hakanpolat/Fiero/README.md

# Fiero Converters
Fiero Converters Offical Github Page

# Turning Coffee Into Electricity

Report link on sharelatex: https://tr.sharelatex.com/read/vdbjvnhbgkjp
