hakanpolat/Fiero/Software2report.pdf

Middle East Technical University

EE464 Power Electronics

# ”Turning Coffee into Electricity”

Project 2 Report

## April 21, 2018

## Asena Melisa SARICI -2031284

## Hakan POLAT -

## U˘gur Can YILMAZ - 2031680

To be submitted to

## Ozan KEYSAN

## Contents

1 Introduction | 2
2 Isolated Converter Simulation | 2
3 Controller Design | 9
4 Load and input Change Adaptation | 12
5 Discussion | 14
6 References | 14

## 1 Introduction

As Fiero Converters, we manufacture 230 V AC to 9 V DC, 10 W Flyback Converters.

This documents shows the detailed pre-manufacturing process of designing, simulating of

the converter and the controller of the product. The design to be used in the simulations

is provided in figure 1.

## 2 Isolated Converter Simulation

The design is made using []. There is snubber in order to reduce the current and voltage

stress the MOSFET endures during operation. The resultant effect of the snubber is

clearly observed in the simulations as well. The simulations were done synchronously

with the implementation and hence the design parameters for the switch, diode and the

transformer are taken from the implemented products.


Figure 1: Flyback Design

### 2.1 Part I. Steady State Operation of the Converter

The figures 2, 3, 4, 5 show the simulation waveforms and the resultant voltage, current and

power outputs for the calculated values of maximum duty cycle, turns ratio, reasonable

capacitor values and resistance for the ideal case.


Figure 2: Load Steady State Voltage

Figure 3: Load Steady State Current

Figure 4: Rectifier Output Voltage at Steady State


Figure 5: All voltage current display values

Moreover, we have also checked that the switch voltage and current remains in the

tolarable range. As expected, the voltage across the switch will be twice the input voltage

when it turns off. This can be seen in figure6.

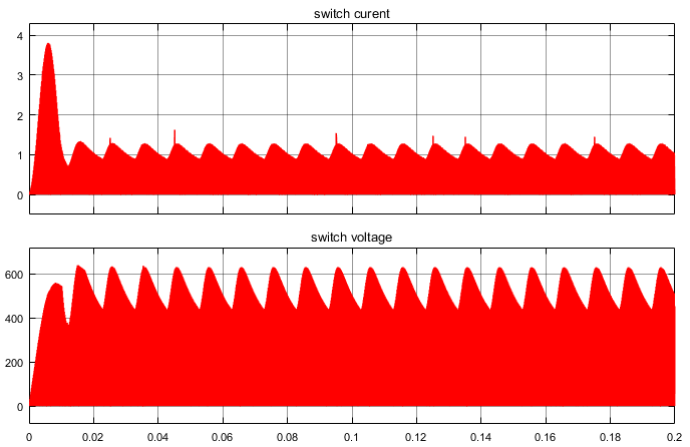
[picture p28: figure]

Figure 6: Current and voltage of the MOSFET during operation

### 2.2 Transformer Design

Throughout the design procedure we followed the steps of Wurth Transformers.

We started our design by defining our specs for the flyback converter which is present in

??.

Vin | 220Vac
Vout | 9 V
Pout | 9 W
Table 1: Specs of our flyback converter design

The flyback converter transfers the power stored in the core in off state and the ∆Ilm

stays the same since its formula depends on constant values.

∆Ilm =

VinDTs
Lm

Therefore it is important to let the core have enough discharge time to avoid saturation.

Taking these limitations into concideration we decided Dmax = 0.4 for the design of the

converter.

Next step the determination of Vin and Vout. We plan on rectifying the AC voltage to DC using a full bridge diode rectifier and generate a DC voltage using a DC-link capacitor.

According to our calculations the Vin,dc varies between 300-325 V. As for the Vout we will

design it for a Vout of 10.5 V which also takes the voltage drop in the diode.

Knowing Dmax,Vin and Vout we can calculate the approximate turns ratio using the formula

below.
N1
N2

=

Dmax

1 − Dmax

Vin,min

Vout

= 19

By recalculating the Dmax we obtain;

Dmax =

19

12 +

300
10.5

= 0.399

The next step is to choose the voltage and current rating of the switch. We are using a

mosfet since it has a faster switching response and the current on the primary side during

on time is low.

During off state the Vout induces voltage on the primary winding which is Vprimary = −Vd.

Therefore the blocking voltage is Vswitch = 2 ∗ Vin,max. Also a safety margin for the

switching peak voltages results in

Vsw,max = 2Vin,max + Vin,max = 3Vin,max = 844V

The current rating can be calculated from

Irated,sw =

Pout

Vout

∗

N2
N1

= 0.05A

Also in this case a safety margin will be added.

The next step is the calculation of the Llm which results in a %25 ripple in Iout(Our

starting assumption is %25) . Again by using the ∆Ilm equation (this time for off state),

Lsekondary =

Vout(1 − Dmax)
0.25Iavg,seconcaryfrequency =

10.5(1 − 0.4)
0.25 ∗ 2 ∗ 62500

= 201.6µH

If we reflect the found Lsecondary to primary we get Lprimary = 72mH.

After calculating the core inductance we should now consider the Ae and Bsat of our core.

Since the equation

Nprimary >

LprimaryIprimary,max

BsatAe

must hold.

Our core has an Ae = 125mm² and Bsat = 0.3T by inserting the values to the equation

we obtain,

Nprimary > 224.64

For calculation simplicity and to make the Nprimary an interger value we selected,

Nprimary = 228

Nsecondary = 12

After selecting the turns ratios we should select proper commercial cables. By checking

the rated currents, fill factor and our core area we choose the cable types AWG28 and

AWG21 for primary and secondary side respectively.

### 2.3 Minimum Load Current Within CCM

To satisfy the continuous conduction mode condition, basically Lm current discharge

completely. To find minimum load current satisfying this condition, ∆Ilm value should

be determined first. Afterwards, half of the ∆Ilm should be equal to the minimum load

current reflected to the primary side so that Lm current never discharges completely.

∆Ilm =

VinDTs
Lm

=

325V ∗ 0.4 ∗ (1/62500)
72mH

= 0.02888A

Half of the ∆Ilm value is the minimum input current for the CCM. In order to find

minimum output current, input current should be reflected.

Iout,min =

∆Ilm
2

Iout,min =

N1
N2

∗ Iout,min = 19 ∗ 0.01444 = 0.27436A

### 2.4 Efficiency of the Converter

In this section, efficiency of the converter will be calculated for different loading conditions.

Efficiency equation of the converter is basically given below.

η =

Vout ∗ Iout

Vin ∗ Iin

For full load condition :

η100 =

Vout ∗ Iout

Vin ∗ Iin

=

9.01 ∗ 1.112
316.5 ∗ 0.04564

=

9.4
12

= 75%

For %75 load condition :

η75 =

Vout ∗ Iout

Vin ∗ Iin

=

9.01 ∗ 0.85
321 ∗ 0.037

=

7.87
11.8

= 66%

For %50 load condition :

η50 =

Vout ∗ Iout

Vin ∗ Iin

=

9.01 ∗ 0.74
321 ∗ 0.032

=

6.7
10.2

= 64%

For %25 load condition :

η25 =

Vout ∗ Iout

Vin ∗ Iin

=

9.01 ∗ 0.64
321 ∗ 0.029

=

5.98
9.3

= 64%

### 2.5 Preliminary Component Selection

In this section, selected components to be used in the implementation will be given.

For the mosfet ;

Vsw,max = 2Vin,max + Vin,max = 3Vin,max = 844V

The current rating can be calculated from

Irated,sw =

Pout

Vout

∗

N2
N1

= 0.05A

According to current and voltage ratings, Toshiba 2SK1119 MOSFET is chosen.It has

1000V drain to source voltage rating and 4A drain current capacity.

Also in the simulation, frequency is chosen to be 62500 Hz. Selected MOSFET is quite

capable of working in this frequency.

For the diode located at the secondary side, MBRA320T3G is chosen. Rating of the

secondary side current is 1.1A which is lower than 3A current rating of the diode. Also breakdown voltage of the diode is 20V which is quite sufficient for the operation.

As a result of calculations in the previous parts, 680 µF capacitor with 1200V voltage

rating will be placed to output of diode rectifier. Another 4.7mF capacitor will placed to

the output of the converter.

For the core selection, we have visited Konya Sokak and due to lack of datasheet, we

have been informed by the seller. According to him, our core has an Ae = 125mm² and

Bsat = 0.3T. We made transformer design according to this information.

## 3 Controller Design

This part contains the desired control design for our flyback converter. The controller is

chosen to be type 2 controller with a schematic shown in figure 9.


Figure 7: Type 2 Controller

### 3.1 Part 1. Controller Transfer Function

The transfer function for the controller is:

v˜c/v˜o = Zfeedback/Zinput

COnsider that the input and output voltages contain DC and ACcomponents, while

the reference is DC. In order to derive the transfer function, consider the AC components:

Zfeedback = 1/sC2//(R2 + 1/sC1)

Zinput = R1Rbias/(R1 + Rbias)

This yield the following transfer function:

Tc(s) = R1 + Rbias

R1Rbias

·

1
C2

·

s + 1/(R1C1)
s(s + (C1 + C2)/R2C1C2)

Here, we observe that the controller is a compensator function. It is in our control

to make it either a lead or lag compensator. For stability, we need an increase in the

phase margin of our close loop system. Hence, we desire the controller to add a phase

lead (boost). Therefore, we need to place a zero before a pole so that first an incline in

the phase occurs. The general bode plot for the controller transfer function is provided

in figure 8, we see that the zero is placed before the pole.

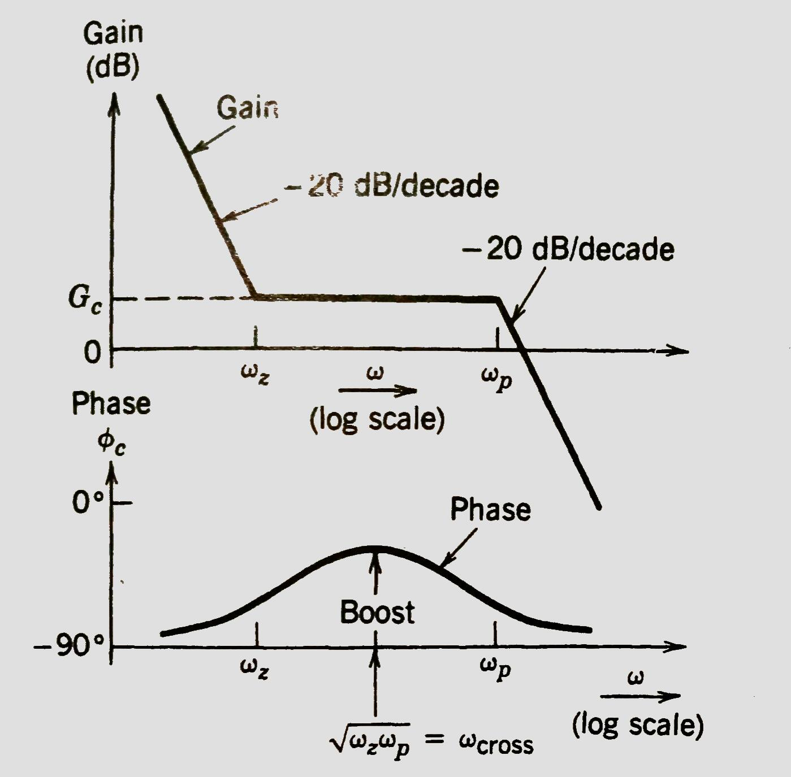
[picture p29: figure]

Figure 8: Type 2 Controller Bode Plot

### 3.2 Controller Computer Simulation -b and c-

The bode plot for type 2 controller is simulated as seen in figure9

This controller was designed for the flyback converter. Since the transfer function


Figure 9: Controller designed for the plant

for a flyback isa nonlinear one, first a system identification is applied on the converter.

Then, not being sure whether this system is fine, literature is researched and an appli-

cation noteof texas instruments(http://www.ti.com/lit/an/slua086/slua086.pdf) is found

explaining in detail of how to select the necessary parameters.

The rightmost zero (the one closer to the unstable region) is found from:

ωrhz =

NV ²
in
RoutLp(Vin + NVout)

(1)

Using the measured inductance of our core, this yields a zero around 0.510⁻⁴ and

according to the document, this zero determines the maximum crossover frequency. Tak-

ing this value as our crossover frequency, one zero and one pole is selected. ωz =

0.0001andωp = 0.001.

Once again the document suggests that for compensation, high gain at low frequencies

is needed. Hence,the gain is selected as 10. For very low frequencies, the gain contribution

of the controller is 1.

The closed loop control works fine and the system settles at the very desired point.

The results are shown in 10 and 11.


Figure 10: Controller output voltage

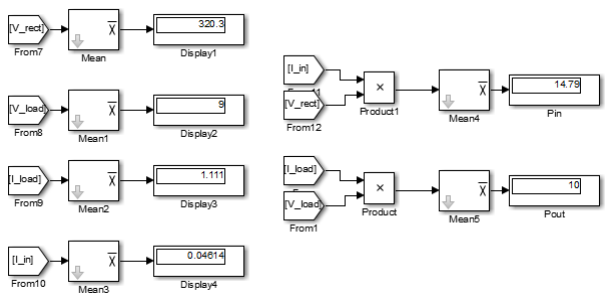
[picture p30: figure]

Figure 11: Controller output values

## 4 Load and input Change Adaptation

The controller behaves very quick and compensated to the load changes as seen in 14 and

15.

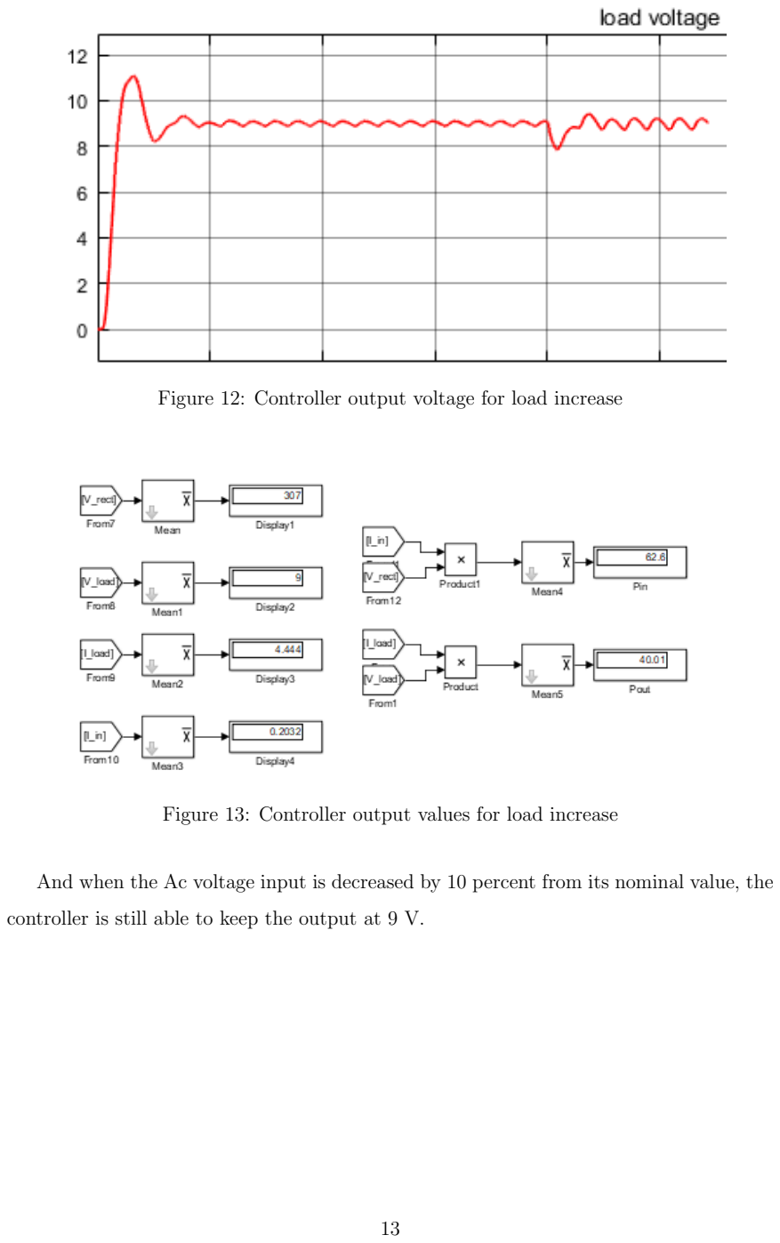
[picture p31: page 14]

Figure 12: Controller output voltage for load increase

Figure 13: Controller output values for load increase

And when the Ac voltage input is decreased by 10 percent from its nominal value, the

controller is still able to keep the output at 9 V.

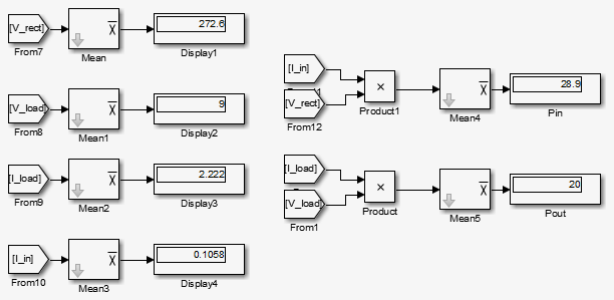
[picture p32: figure]

Figure 14: Controller output voltage for input decrease 200V AC

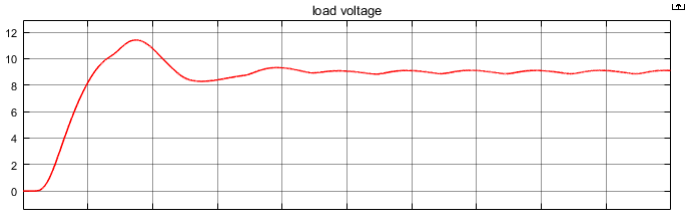
[picture p33: figure]

Figure 15: Controller output values for input decrease 200V AC

## 5 Discussion

This controller performs very quick and the output oscillation is acceptable. At the very

beginning it has an overshoot but this overshoot settles quickly. The controller is capable

of adjusting to both input and output changes.

Looking at the frequency response ?? and the crossover frequency we have calculated

from the document base equation 1, we see that the derived and simulated values do fit.

And we observe that the controller works nice.


Figure 16: Frequency response of the flyback from system identification

## 6 References

- https://www.digikey.com/Web
- http://www.alldatasheet.com/datasheet-pdf/pdf/30564/TOSHIBA/2SK1119.html
- http://www.alldatasheet.com/datasheet-pdf/pdf/30564/TOSHIBA/2SK1119.html
- http://datasheetz.com/data/Discrete
- http://keysan.me/ee464/
- http://www.ti.com/lit/an/slua086/slua086.pdf
