hakanpolat/Fiero/Design_calculations.jpeg

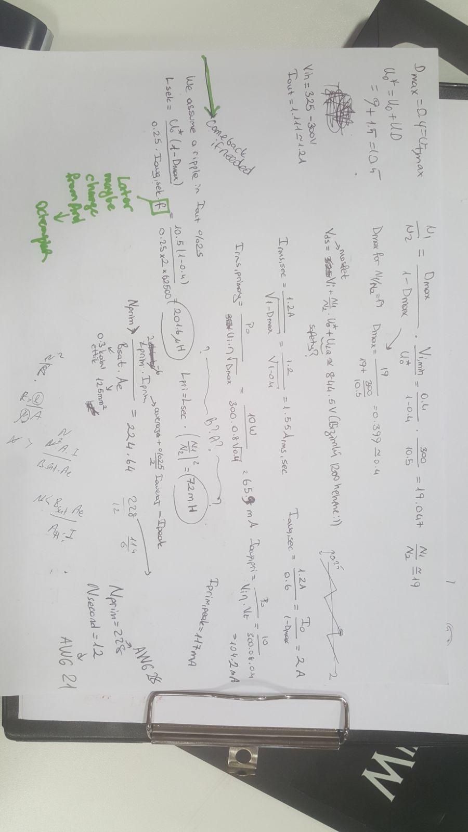
Design_calculations.jpeg
