hakanpolat/Fiero/PCB_figure.PNG

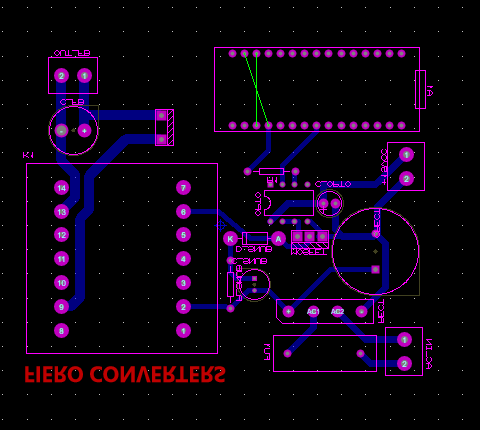
PCB_figure.PNG
