hakanpolat/Fiero/Report/effic75.PNG

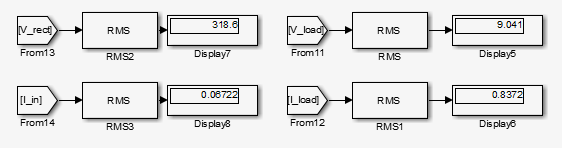
Report/effic75.PNG
