hakanpolat/Fiero/Report/effic100.PNG

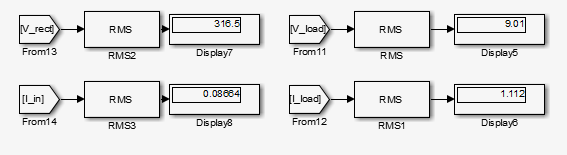
Report/effic100.PNG
