hakanpolat/Fiero/Report/SystemIdent_model.PNG

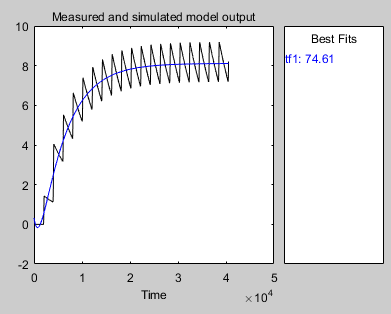
Report/SystemIdent_model.PNG
