hakanpolat/Fiero/(list of files, drawings)

Other design files:
PCB.pdsprj
PCB_pot.pdsprj
