hakanpolat/Fiero/(commit log)

2018-03-28 A better designed simulation
    Both rectification and ideal components are used. Current ripple is really small, the rectified output is filtered with a 47uf capacitor. There is a 8.1 ohms hand calculated resistor with a 4700uf capacitor (I dont know whether it is that crucial to use a large capacitance there, it could be smaller since the ripple is allright). The turns ratio is selected as 1 and parameters dor the Lm and leakage etc. are taken from a component found in Digikey for a flyback converter. (592 uH Lm) Yet, there is an increased ampunt of stress on the switch considering the voltage (Uin orders of kVs)
    For inductors:
    https://www.digikey.com/products/en/transformers/switching-con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
2018-04-07 Arduino PWM code for flyback converter
2018-05-02 PCBDesign
    PCB is completed.The elements selected are tested in the laboratory. After satisfactory results, PCB is drawn to decrease the parasitic inductance. The switch mode and AC side loop is minimized.
    [PCB.pdsprj]
2018-05-02 PCB looks like this
2018-05-03 PCB_redrawn for nano
    [PCB.pdsprj]
2018-05-06 PCB again :smiley:
    [PCB.pdsprj, PCB_pot.pdsprj]
2018-06-01 Design Guideline for all and especially for ripple
    Fairchild's very nice guideline. It has all necessary explanation for design procdure. I have learned that the output ripple we see depends on the MOSFET drain source peak current, output capacitor ESR, output capacitance value and fsw. Moreover, the snubber resistance affects the MOS peak current. Hence, in order to decrease output ripple we need to increase the Rsnub. (we used 1 kohm, the design recomends 33k). It is good to use a Csnub that can endure the primary side voltage(10 nF-1kV recommended). The multioutput design shows a similar Vout. Here we see that egp30d is used which is an ultra fastrecovery diode. Also a 10-20 ohm resist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
2018-06-02 control code for Arduino
2018-06-03 new codes
    [PCB.pdsprj]
